eszkadev/nixie-clock/nixie.jpg

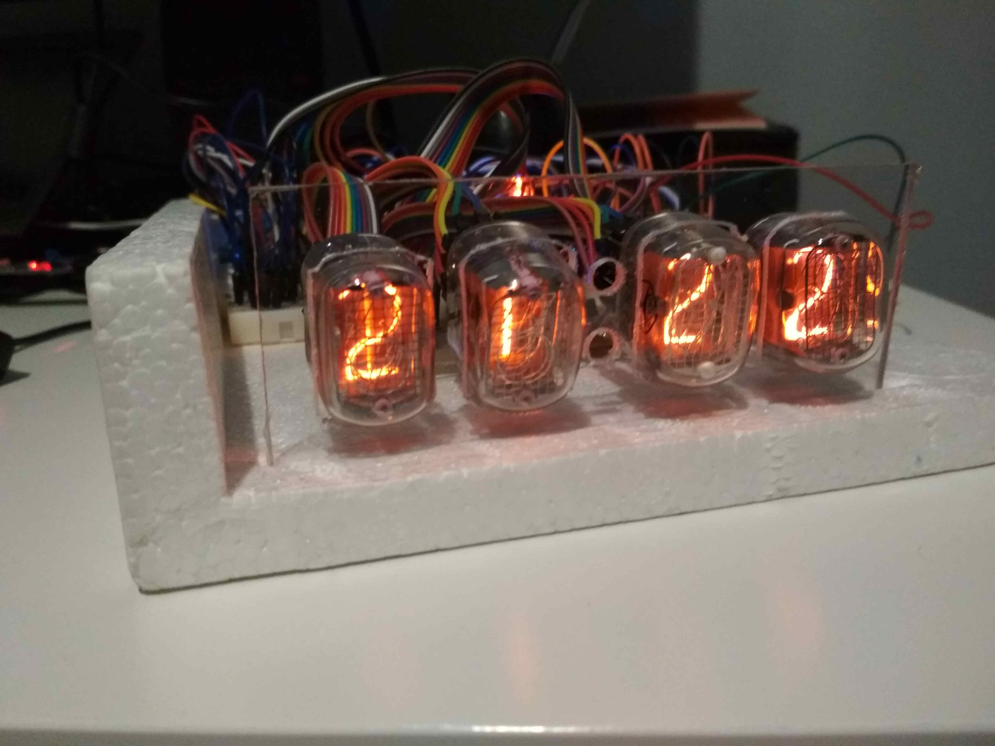
nixie.jpg
