eszkadev/nixie-clock/nixie-display/pcb_short.pdf

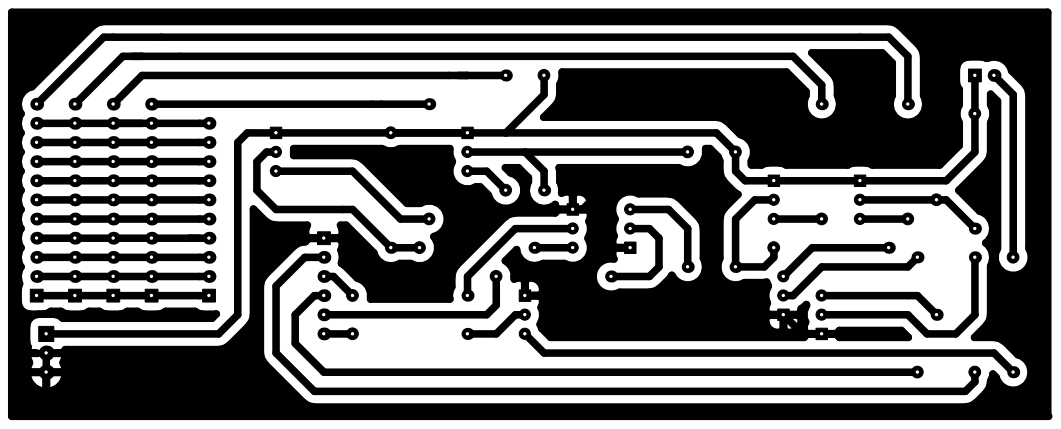
[picture p2: page 1]
