eszkadev/nixie-clock/nixie-display/pcb_short_mirrored.pdf

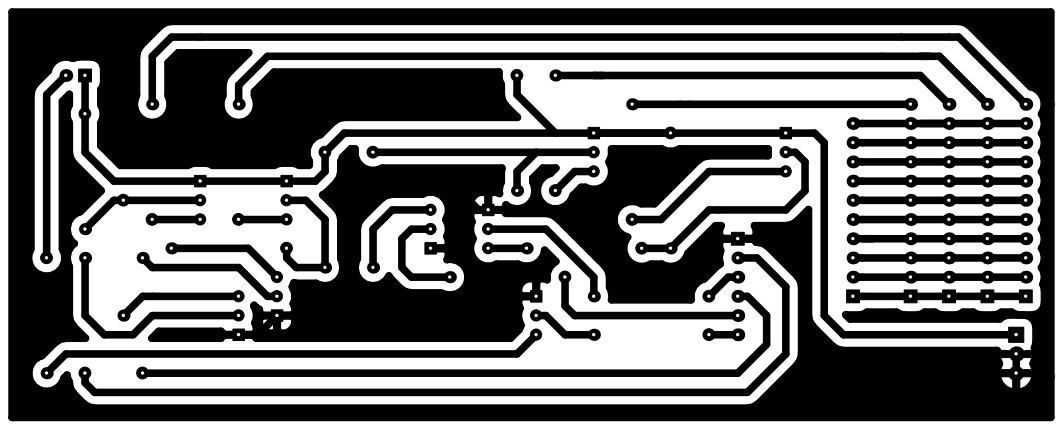
[picture p3: page 1]
