eszkadev/nixie-clock/nixie-display/pcb.pdf

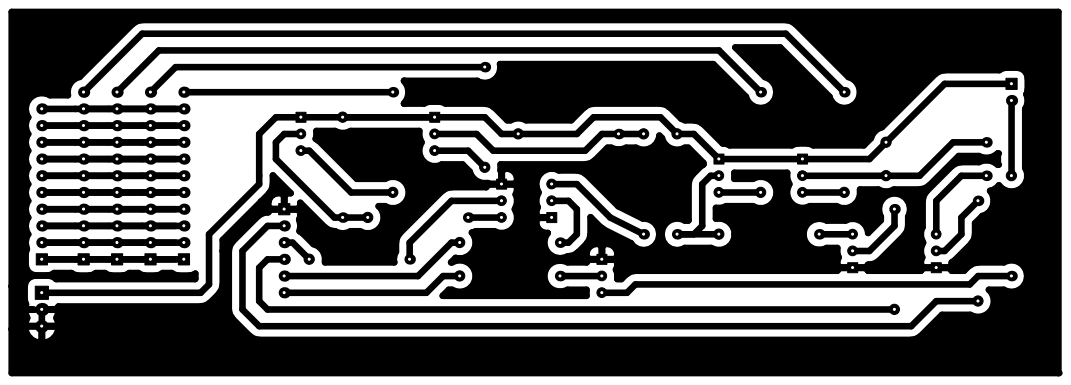
[picture p4: page 1]
