eszkadev/nixie-clock/nixie-display/pcb_mirrored.pdf

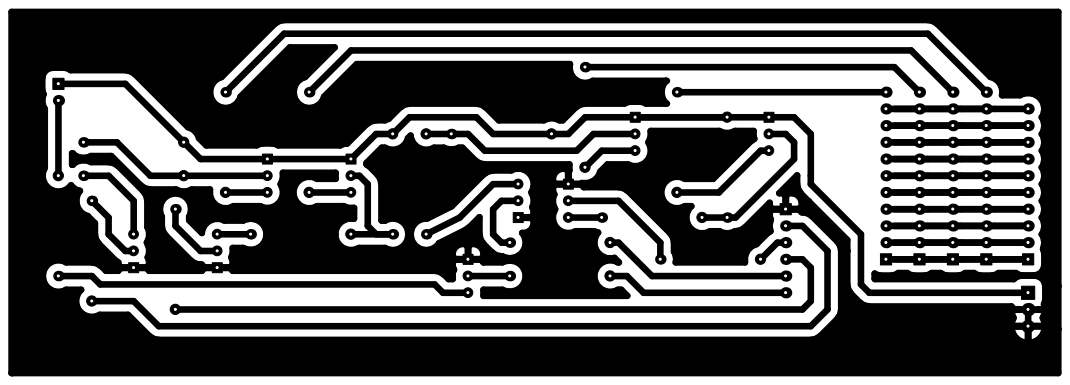
[picture p5: page 1]
