eszkadev/nixie-clock/boost-converter/boost-converter.pdf

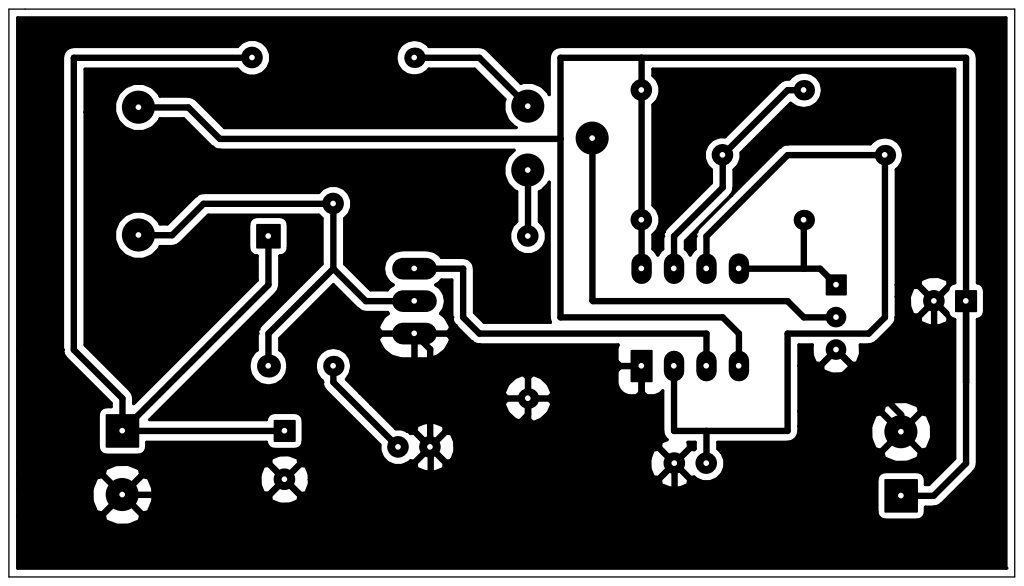
[picture p6: page 1]
