eszkadev/nixie-clock/nixie-display/nixie-display.kicad_pcb

## KiCad design nixie-display/nixie-display.kicad_pcb (2017-12-05)

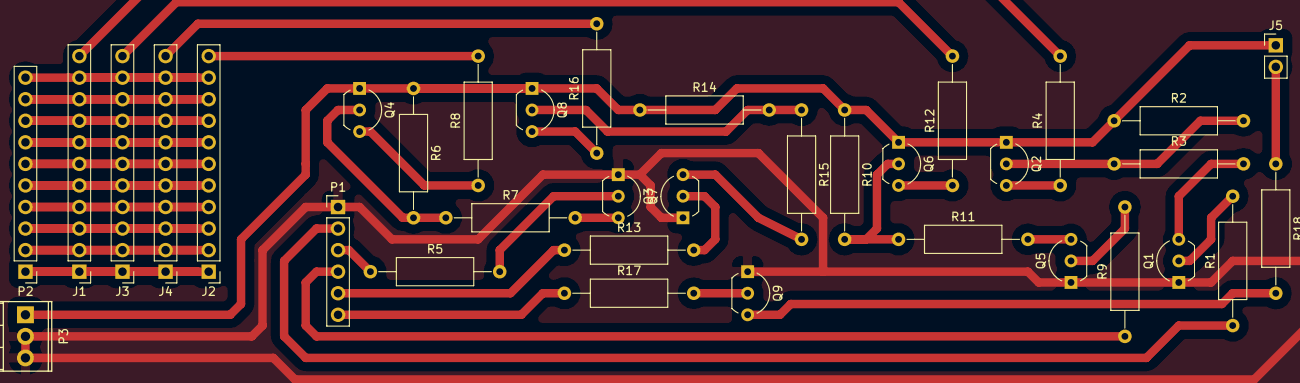
[picture p7: board nixie-display.kicad_pcb from above]

Board: 2 copper layers, 35 parts (0 on the bottom side), 40 nets.

Parts:
J1, J2, J3, J4: Conn_01x11; Socket_Strip_Straight_1x11_Pitch2.54mm
J5: Conn_01x02; Socket_Strip_Straight_1x02_Pitch2.54mm
P1: CONN_01X06; Socket_Strip_Straight_1x06_Pitch2.54mm
P2: CONN_01X10; Socket_Strip_Straight_1x10_Pitch2.54mm
P3: CONN_01X03; TerminalBlock_Pheonix_MPT-2.54mm_3pol
Q1, Q3, Q5, Q7, Q9: MPSA42; TO-92_Inline_Wide
Q2, Q4, Q6, Q8: MPSA92; TO-92_Inline_Wide
R1, R5, R9, R13, R17: 33K; R_Axial_DIN0309_L9.0mm_D3.2mm_P15.24mm_Horizontal
R2, R6, R10, R14: 100K; R_Axial_DIN0309_L9.0mm_D3.2mm_P15.24mm_Horizontal
R3, R7, R11, R15: 470K; R_Axial_DIN0309_L9.0mm_D3.2mm_P15.24mm_Horizontal
R4, R8, R12, R16: 47K; R_Axial_DIN0309_L9.0mm_D3.2mm_P15.24mm_Horizontal
R18: 220K; R_Axial_DIN0309_L9.0mm_D3.2mm_P15.24mm_Horizontal

Connections:
GND: P1.1, P3.2, P3.3, Q1.1, Q3.1, Q5.1, Q7.1, Q9.1
unnamed: J1.1, J2.1, J3.1, J4.1, P2.1
unnamed: J1.2, J2.2, J3.2, J4.2, P2.2
unnamed: J1.3, J2.3, J3.3, J4.3, P2.3
unnamed: J1.4, J2.4, J3.4, J4.4, P2.4
unnamed: J1.5, J2.5, J3.5, J4.5, P2.5
unnamed: J1.6, J2.6, J3.6, J4.6, P2.6
unnamed: J1.7, J2.7, J3.7, J4.7, P2.7
unnamed: J1.8, J2.8, J3.8, J4.8, P2.8
unnamed: J1.9, J2.9, J3.9, J4.9, P2.9
unnamed: J1.10, J2.10, J3.10, J4.10, P2.10
unnamed: J1.11, R4.2
unnamed: J2.11, R8.2
unnamed: J3.11, R12.2
unnamed: J4.11, R16.2
unnamed: J5.2, R18.1
unnamed: P1.2, R1.1
unnamed: P1.3, R5.1
unnamed: P1.4, R9.1
unnamed: P1.5, R13.1
unnamed: P1.6, R17.1
unnamed: Q1.2, R1.2
unnamed: Q1.3, R3.2
unnamed: Q2.2, R2.2, R3.1
unnamed: Q2.3, R4.1
unnamed: Q3.2, R5.2
unnamed: Q3.3, R7.2
unnamed: Q4.2, R6.2, R7.1
unnamed: Q4.3, R8.1
unnamed: Q5.2, R9.2
unnamed: Q5.3, R11.2
unnamed: Q6.2, R10.2, R11.1
unnamed: Q6.3, R12.1
unnamed: Q7.2, R13.2
unnamed: Q7.3, R15.2
unnamed: Q8.2, R14.2, R15.1
unnamed: Q8.3, R16.1
unnamed: Q9.2, R17.2
unnamed: Q9.3, R18.2
VCC: J5.1, P3.1, Q2.1, Q4.1, Q6.1, Q8.1, R2.1, R6.1, R10.1, R14.1
