eszkadev/nixie-clock/boost-converter/boost-converter.kicad_pcb

## KiCad design boost-converter/boost-converter.kicad_pcb (2017-02-04)

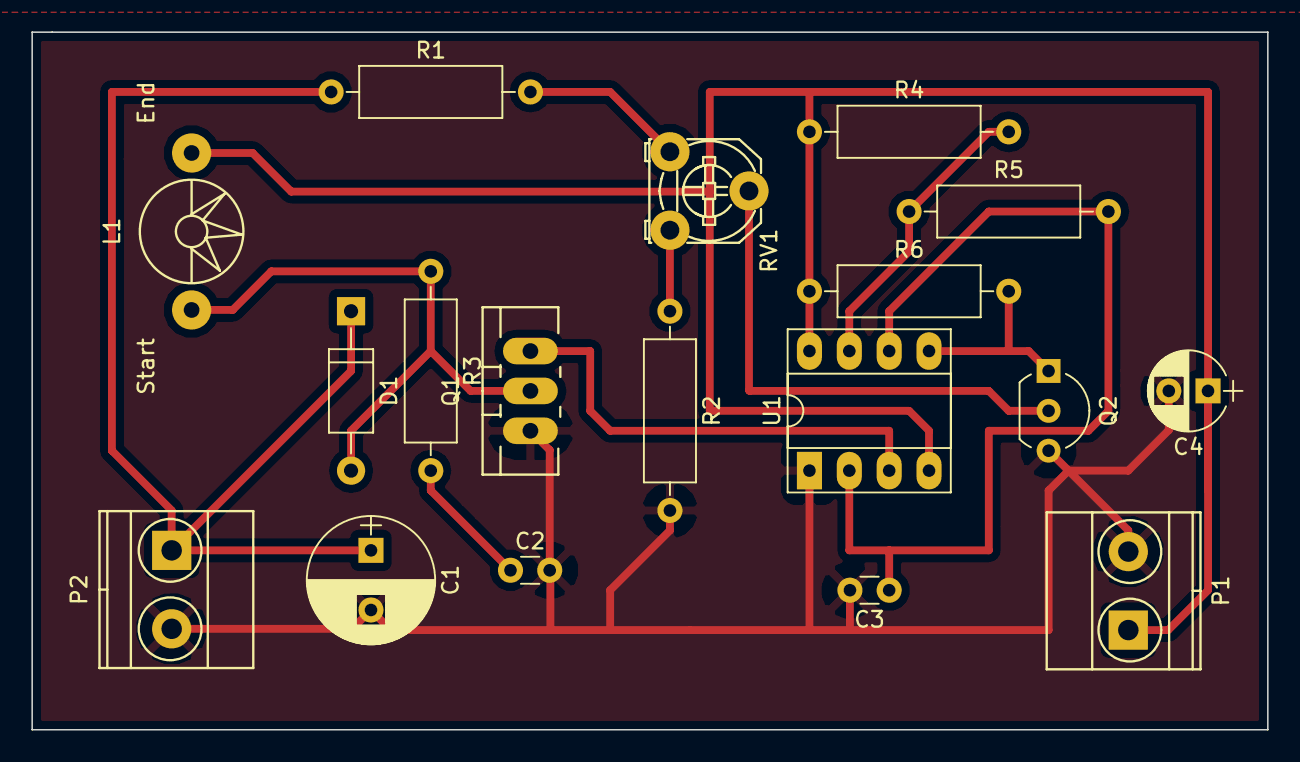
[picture p8: board boost-converter.kicad_pcb from above]

Board: 2 copper layers, 78.7 x 44.4 mm, 18 parts (0 on the bottom side), 12 nets.

Parts:
C1: 2.2uF; CP_Radial_D8.0mm_P3.80mm
C2: 100pF; C_Disc_D3.0mm_W1.6mm_P2.50mm
C3: 2n2; C_Disc_D3.0mm_W1.6mm_P2.50mm
C4: 330uF; CP_Radial_D5.0mm_P2.50mm
D1: UF4004; D_A-405_P10.16mm_Horizontal
L1: 100uH; Choke_Toroid_horizontal_Diameter7-5mm_Amidon-T25
P1, P2: CONN_02X01; TerminalBlock_Pheonix_MKDS1.5-2pol
Q1: IRF730; TO-220_Neutral123_Vertical_LargePads
Q2: BC547; TO-92_Inline_Wide
R1: 220k; R_Axial_DIN0309_L9.0mm_D3.2mm_P12.70mm_Horizontal
R2: 470R; R_Axial_DIN0309_L9.0mm_D3.2mm_P12.70mm_Horizontal
R3: 2k2; R_Axial_DIN0309_L9.0mm_D3.2mm_P12.70mm_Horizontal
R4: 1k; R_Axial_DIN0309_L9.0mm_D3.2mm_P12.70mm_Horizontal
R5: 10k; R_Axial_DIN0309_L9.0mm_D3.2mm_P12.70mm_Horizontal
R6: 56k; R_Axial_DIN0309_L9.0mm_D3.2mm_P12.70mm_Horizontal
RV1: 1k; Potentiometer_Triwood_RM-065
U1: NE555; DIP-8_W7.62mm_Socket_LongPads

Connections:
+9V: C4.1, L1.2, P1.1, R4.1, R6.1, U1.4, U1.8
Earth: C1.2, C2.2, C3.2, C4.2, P1.2, P2.2, Q1.1, Q2.3, R2.2, U1.1
unnamed: C2.1, R3.2
unnamed: C3.1, R5.2, U1.2, U1.6
unnamed: D1.2, L1.1, Q1.2, R3.1
unnamed: Q1.3, U1.3
unnamed: Q2.1, R6.2, U1.5
unnamed: Q2.2, RV1.2
unnamed: R1.2, RV1.1
unnamed: R2.1, RV1.3
unnamed: R4.2, R5.1, U1.7
VSSA: C1.1, D1.1, P2.1, R1.1
