eszkadev/nixie-clock/atmega-sources/config.h

/*
 * Copyright © 2016
 * Szymon Kłos, Robert Jankowski, Wojciech Tokarski
 * All rights reserved.
 *
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
 * THIS SOFTWARE IS PROVIDED BY THE COPYRIGHT HOLDERS AND CONTRIBUTORS "AS IS" AND
 * ANY EXPRESS OR IMPLIED WARRANTIES, INCLUDING, BUT NOT LIMITED TO, THE IMPLIED
 * WARRANTIES OF MERCHANTABILITY AND FITNESS FOR A PARTICULAR PURPOSE ARE DISCLAIMED.
 * IN NO EVENT SHALL SZYMON KŁOS, ROBERT JANKOWSKI, WOJCIECH TOKARSKI BE LIABLE FOR
 * ANY DIRECT, INDIRECT, INCIDENTAL, SPECIAL, EXEMPLARY, OR CONSEQUENTIAL DAMAGES
 * (INCLUDING, BUT NOT LIMITED TO, PROCUREMENT OF SUBSTITUTE GOODS OR SERVICES;
 * LOSS OF USE, DATA, OR PROFITS; OR BUSINESS INTERRUPTION) HOWEVER CAUSED AND
 * ON ANY THEORY OF LIABILITY, WHETHER IN CONTRACT, STRICT LIABILITY, OR TORT
 * (INCLUDING NEGLIGENCE OR OTHERWISE) ARISING IN ANY WAY OUT OF THE USE OF THIS
 * SOFTWARE, EVEN IF ADVISED OF THE POSSIBILITY OF SUCH DAMAGE.
 * */

#ifndef CONFIG_H_
#define CONFIG_H_

/*
 * Config file - describes the device configuration
 */

/*
 * Platform - determines which MCU is used
 * Supported values:
 */

#define ATMEGA328 1
#define ATMEGA16  2

#define _PLATFORM ATMEGA16

/*
 * Clock - determines the clock frequency
 */

#define _CLOCK F_CPU

/*
 * Baud rate - determines the baud rate used to communicate with PC
 * Supported values:
 * clock 8 MHz:
 *     9600
 *     19200
 *     38400
 *     57600 !!! Error = 2.1 %
 *     76800
 */

#define _BAUD_RATE 9600

#define RTC

#endif /* CONFIG_H_ */
