eszkadev/nixie-clock/(commit log)

2017-02-01 Boost converter schematic
    [boost-converter.kicad_pcb, boost-converter.sch]
2017-02-01 Zmiana footprintu potencjometru
    [boost-converter.kicad_pcb]
2017-02-04 Dokończone pcb + pdf
    [boost-converter.kicad_pcb]
2017-02-17 Set current time
2017-02-17 Added timer interrupt
2017-02-17 Added time setup over uart
2017-03-04 Added nixie KiCad library with IN-12B symbol
    [nixie-display.kicad_pcb, nixie-display.sch]
2017-03-04 Added KiCad footprint for IN-12B tube
2017-03-04 Added tubes to the schematic and footprint library path
    [nixie-display.sch]
2017-03-04 Added neon tube lamp to the nixie library
2017-03-04 Nixie display schematic
    [nixie-display.sch]
2017-03-04 Added PWR_FLAG
    [nixie-display.sch]
2017-03-04 Assigned footprints
    [nixie-display.sch]
2017-12-05 Finished nixie-display pcb
    [nixie-display.kicad_pcb, nixie-display.sch]
2017-12-21 Second pcb version with different size
    [nixie-display-shorter.kicad_pcb]
2017-12-30 Add switch for RTC
2018-01-08 Arduino sketch for NodeMCU
2018-01-08 Correct digits to my wiring
    [multiplexing.c]
2018-01-08 Working second timer for at16
2018-01-15 Added labels to scheme
    [nixie-display.sch]
2018-01-15 Correct dir for arduiono sketch
    [wifi_clock.ino]
